SaidAlvarado/UVA---High-power-ultraviolet-flashlight/PCB/High Power Led Driver/AL8853_Led_driver/Output/AL8853_Led_driver_3d_model.png

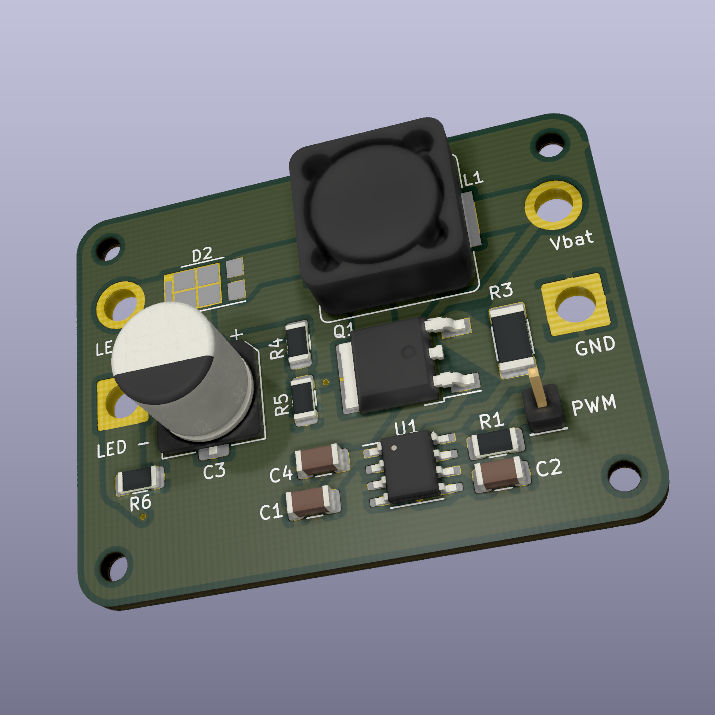
PCB/High Power Led Driver/AL8853_Led_driver/Output/AL8853_Led_driver_3d_model.png
