SaidAlvarado/UVA---High-power-ultraviolet-flashlight/Firmware/README.md

# UVA Firmware #

Main firmware for the UVA, and examples for each sensor.

## Requirements ##

1. [LM73-Q1 Temperature Sensor](examples/LM73/README.md)

2. [VL53L1X Distance Sensor](examples/VL53L1X/README.md)

3. [SSD1306 OLED](examples/SSD1306/README.md)

## Examples ##

### [LM73-Q1 Temperature Sensor](examples/LM73/README.md) ###

- [Oneshot](examples/LM73/oneshot/oneshot.ino): this is an example from the [LM73 Library](https://github.com/zkemble/LM73) that starts a new reading, waits until the temperature measurement is ready and then shows the results in the serial monitor. Once the measurement is ready, it starts a new one and the cycle begins again.

- [Continuous Reading](examples/LM73/continuous_reading/continuous_reading.ino): this example takes a continuous temperature readings and displays the results each 1000 mseg in the terminal monitor (9600 Baud).

### [VL53L1X Distance Sensor](examples/VL53L1X/README.md) ###

- [ReadDistance](examples/VL53L1X/Example1_ReadDistance/Example1_ReadDistance.ino): this is an example from the [VL53L1X Library](https://github.com/sparkfun/SparkFun_VL53L1X_Arduino_Library) that starts a new reading, waits until the distance measurement is ready and then shows the results in the serial monitor. Once the measurement is ready, it starts a new one and the cycle begins again.

### [SSD1306 OLED](examples/SSD1306/README.md) ###

- [SSD1306 128x64 I2C Demo](examples/SSD1306/ssd1306_128x64_i2c/ssd1306_128x64_i2c.ino): this is an example from the [Adafruit SSD1306 Library](https://github.com/adafruit/Adafruit_SSD1306) that plays a demo, it tests all the different functions in the library.

## Main ##

- [uva-main](uva-main/uva-main.ino): This is the completed firmware of the Flashlight. It reads all the sensors, turns on the LEDs at 100mW/cm^2 and reports relevant information to the OLED screen.
