SaidAlvarado/UVA---High-power-ultraviolet-flashlight/Firmware/examples/SSD1306/README.md

# OLED SSD1306 #

* [Library](https://github.com/adafruit/Adafruit_SSD1306)

## Installation ##

If you are using version 1.6.2 or later of the Arduino software (IDE), you can use the Library Manager to install this library:

1. In the Arduino IDE, open the "Sketch" menu, select "Include Library", then "Manage Libraries...".
2. Search for "SSD1306".
3. Click the "Adafruit SSD1306" entry in the list.
4. Click "Install".

If this does not work, you can manually install the library:

1. Download the [latest release archive from GitHub](https://github.com/adafruit/Adafruit_SSD1306/archive/master.zip) and decompress it.
2. Rename the folder "Adafruit_SSD1306-master" to "Adafruit_SSD1306".
3. Move the "Adafruit_SSD1306" folder into the "libraries" directory inside your Arduino sketchbook directory. You can view your sketchbook location by opening the "File" menu and selecting "Preferences" in the Arduino IDE. If there is not already a "libraries" folder in that location, you should make the folder yourself.
After installing the library, restart the Arduino IDE.
4. After installing the library, restart the Arduino IDE.

## Examples ##

* [SSD1306 128x64 I2C Demo](./ssd1306_128x64_i2c/ssd1306_128x64_i2c.ino): this is an example from the [Adafruit SSD1306 Library](https://github.com/adafruit/Adafruit_SSD1306) that plays a demo, it tests all the different functions in the library.
