SaidAlvarado/UVA---High-power-ultraviolet-flashlight/Firmware/examples/VL53L1X/README.md

# VL53L1X Distance Sensor #

* [Library](https://github.com/sparkfun/SparkFun_VL53L1X_Arduino_Library)

## Installation ##

If you are using version 1.6.2 or later of the Arduino software (IDE), you can use the Library Manager to install this library:

1. In the Arduino IDE, open the "Sketch" menu, select "Include Library", then "Manage Libraries...".
2. Search for "VL53L1X".
3. Click the "SparkFun VL53L1X 4m Laser Distance Sensor" entry in the list.
4. Click "Install".

If this does not work, you can manually install the library:

1. Download the [latest release archive from GitHub](https://github.com/sparkfun/SparkFun_VL53L1X_Arduino_Library/archive/master.zip) and decompress it.
2. Rename the folder "SparkFun_VL53L1X_Arduino_Library-master" to "SparkFun_VL53L1X_Arduino_Library".
3. Move the "SparkFun_VL53L1X_Arduino_Library" folder into the "libraries" directory inside your Arduino sketchbook directory. You can view your sketchbook location by opening the "File" menu and selecting "Preferences" in the Arduino IDE. If there is not already a "libraries" folder in that location, you should make the folder yourself.
After installing the library, restart the Arduino IDE.
4. After installing the library, restart the Arduino IDE.

## Examples ##

* [ReadDistance](./Example1_ReadDistance/Example1_ReadDistance.ino):  this is an example from the [VL53L1X Library](https://github.com/sparkfun/SparkFun_VL53L1X_Arduino_Library) that starts a new reading, waits until the distance measurement is ready and then shows the results in the serial monitor. Once the measurement is ready, it starts a new one and the cycle begins again.
