SaidAlvarado/UVA---High-power-ultraviolet-flashlight/PCB/High Power Led Driver/AL8853_Led_driver/Output/g1480.png

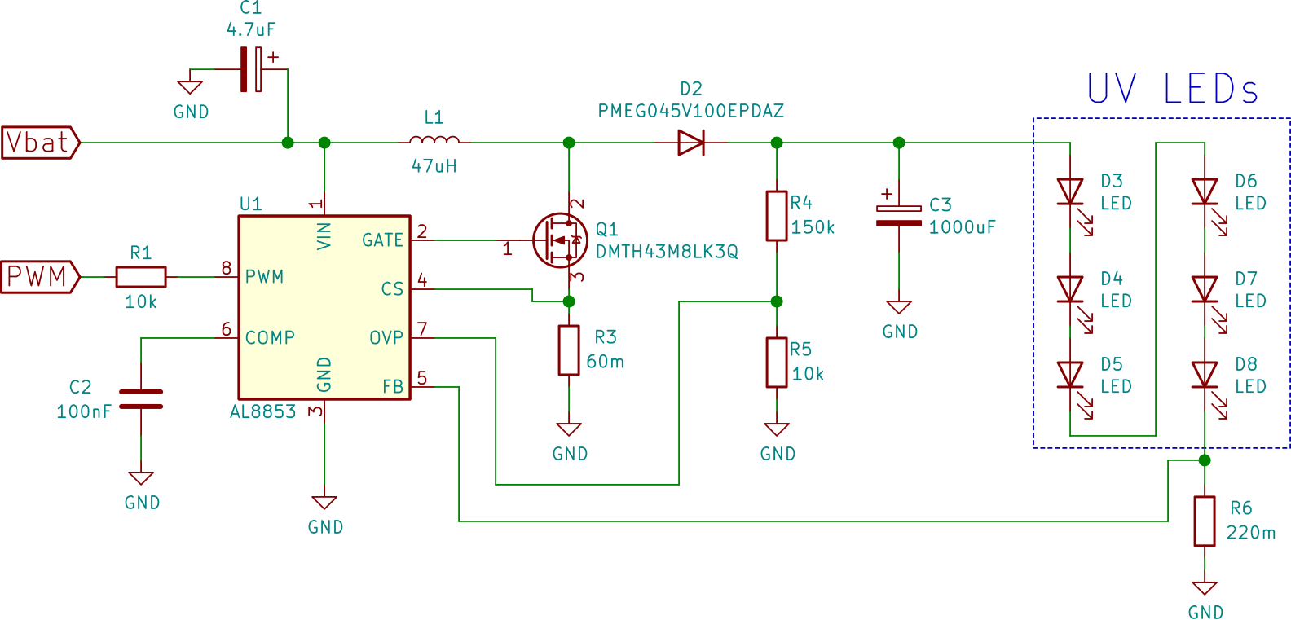
PCB/High Power Led Driver/AL8853_Led_driver/Output/g1480.png
