SaidAlvarado/UVA---High-power-ultraviolet-flashlight/PCB/High Power Led Driver/AL8853_Led_driver/AL8853_Led_driver.step

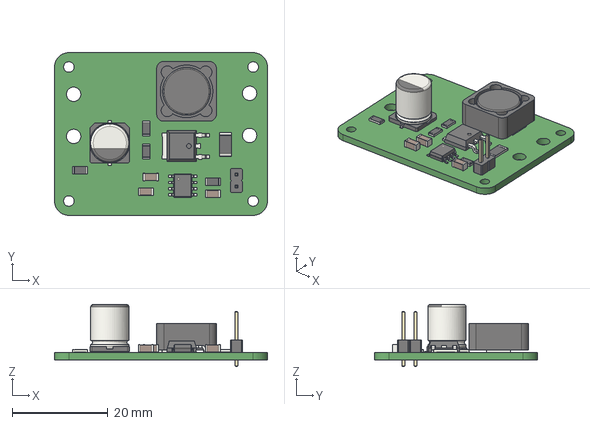
[picture p3: CAD file, 2020-10-05]
PCB/High Power Led Driver/AL8853_Led_driver/AL8853_Led_driver.step
44.5 x 34.0 x 13.0 mm
