SaidAlvarado/UVA---High-power-ultraviolet-flashlight/PCB/UV LED BULB/inulox_led_bulb/inulox_led_bulb.step

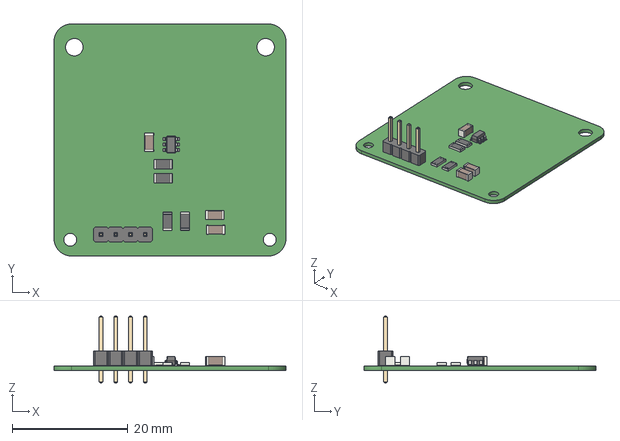
[picture p4: CAD file, 2020-10-05]
PCB/UV LED BULB/inulox_led_bulb/inulox_led_bulb.step
40.0 x 40.0 x 11.5 mm
