SaidAlvarado/UVA---High-power-ultraviolet-flashlight/PCB/Arduino CPU Board/Arduino_CPU_Board/ouput/Arduino_CPU_Board.pdf

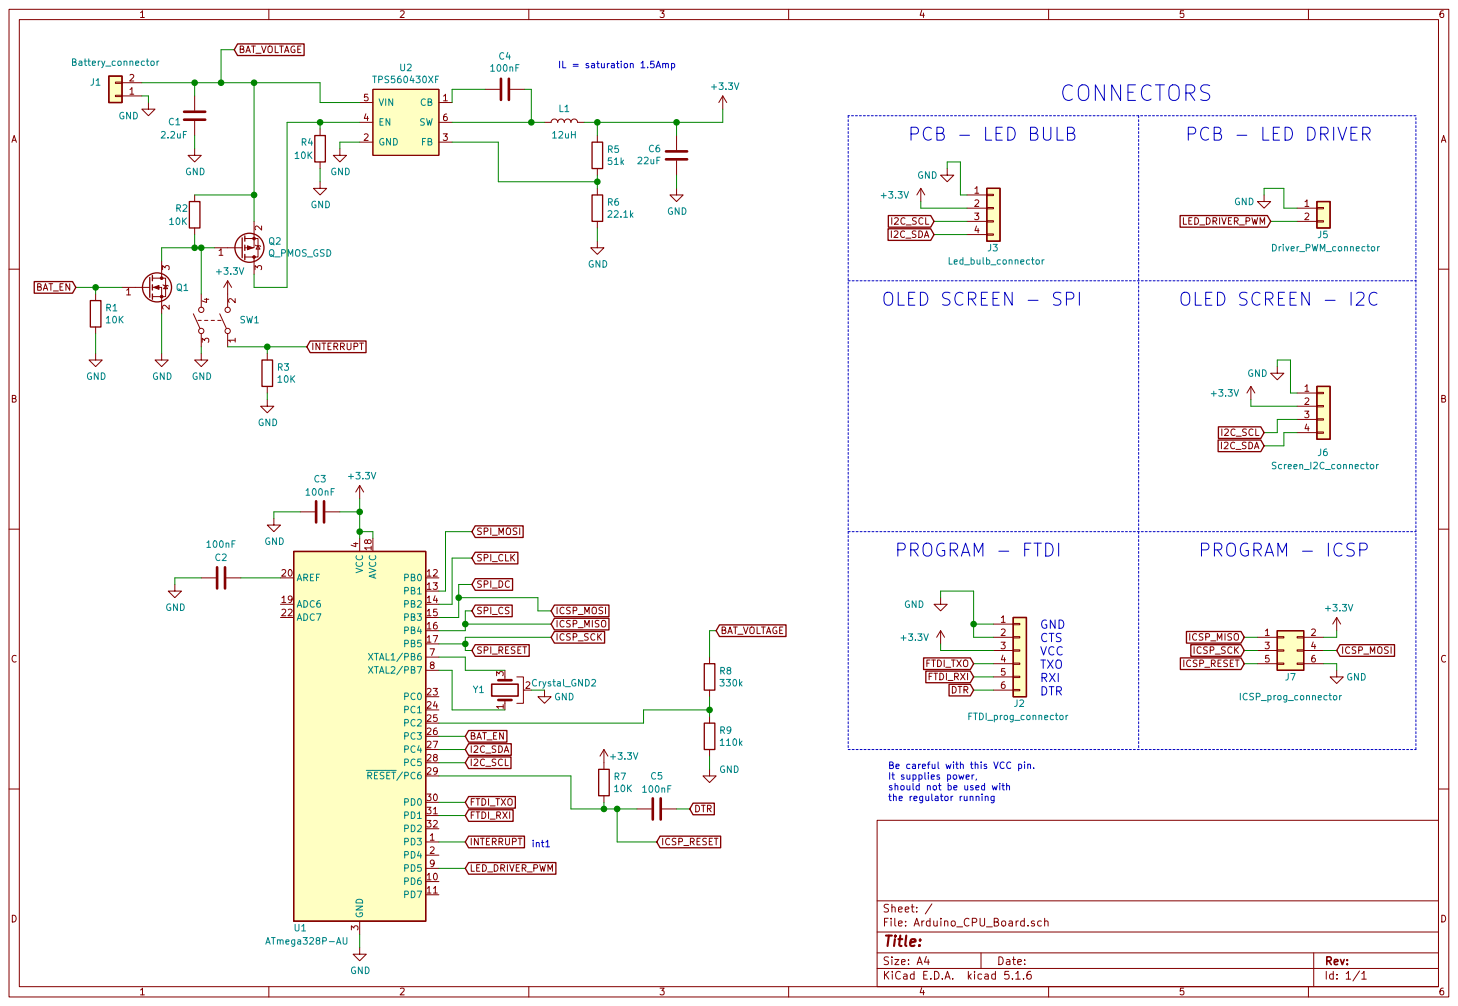
[picture p5: page 1]

It supplies power, should not be used with
