SaidAlvarado/UVA---High-power-ultraviolet-flashlight/PCB/High Power Led Driver/AL8853_Led_driver/Output/AL8853_Led_driver.pdf

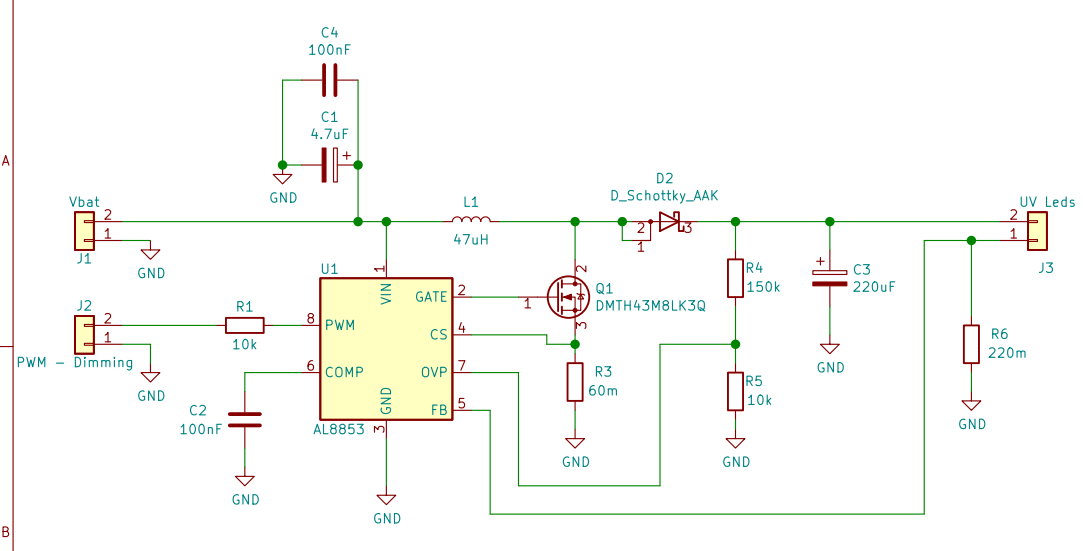
[picture p6: page 1]

3 CS 4 FB 5 COMP 6 OVP 7 PWM 8 U1 AL8853 GND

File: AL8853_Led_driver.sch Sheet: /
Id: 1/1 Title: AL8853 Constant Current - 24w - UV LED Driver
