SaidAlvarado/UVA---High-power-ultraviolet-flashlight/PCB/UV LED BULB/inulox_led_bulb/Output/inulox_led_bulb.pdf

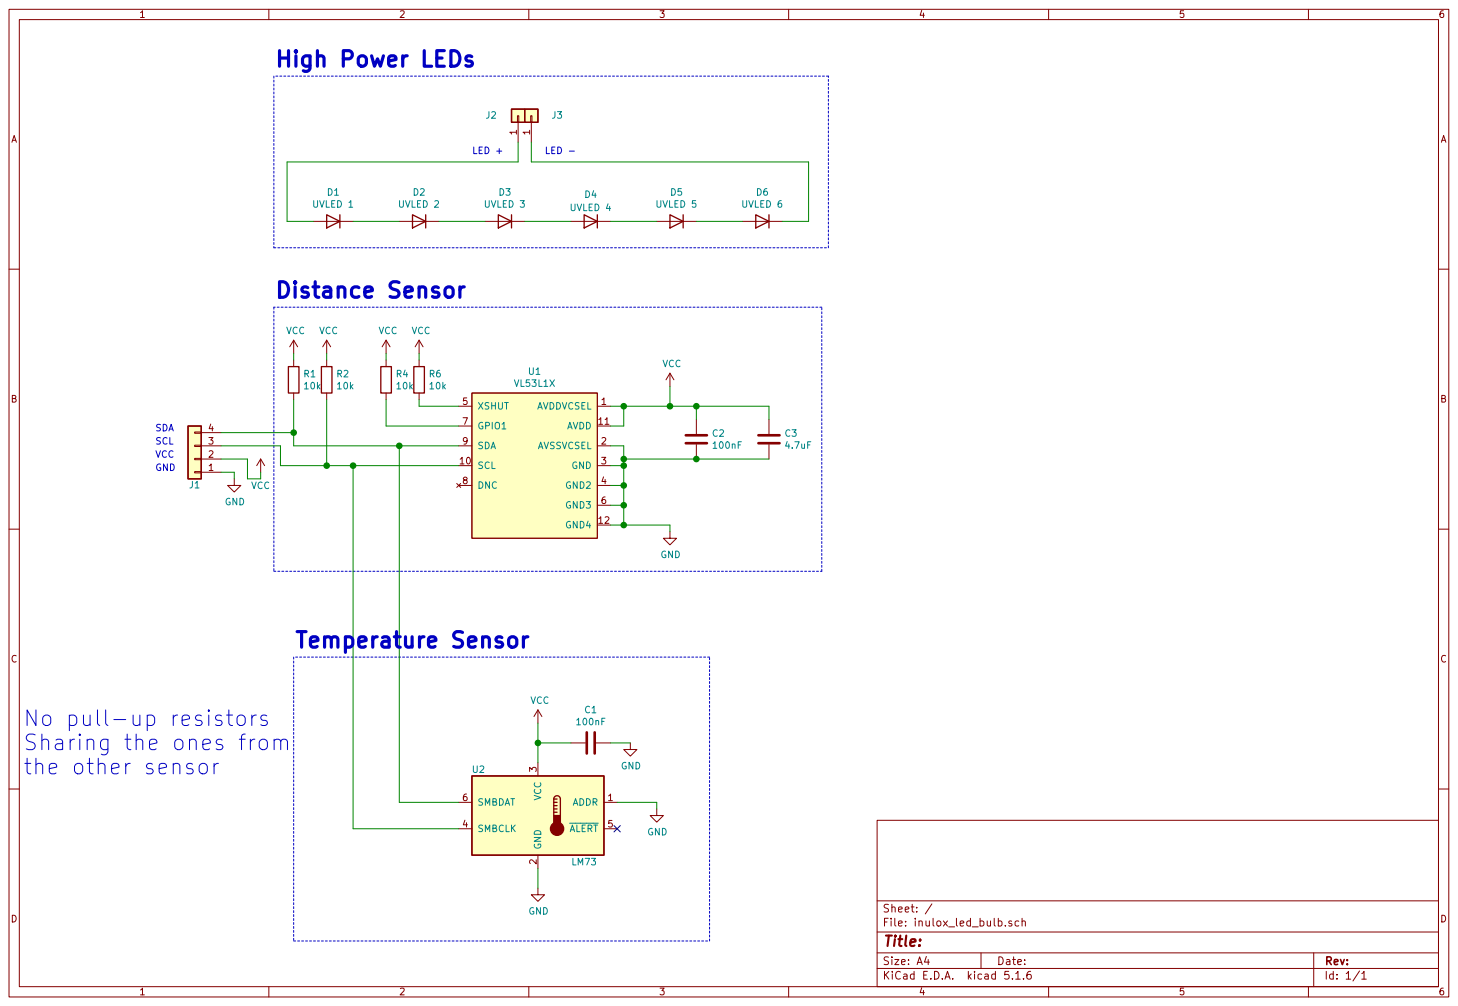
[picture p7: page 1]

Sharing the ones from
the other sensor
