SaidAlvarado/UVA---High-power-ultraviolet-flashlight/PCB/Arduino CPU Board/Arduino_CPU_Board/Arduino_CPU_Board.pdf

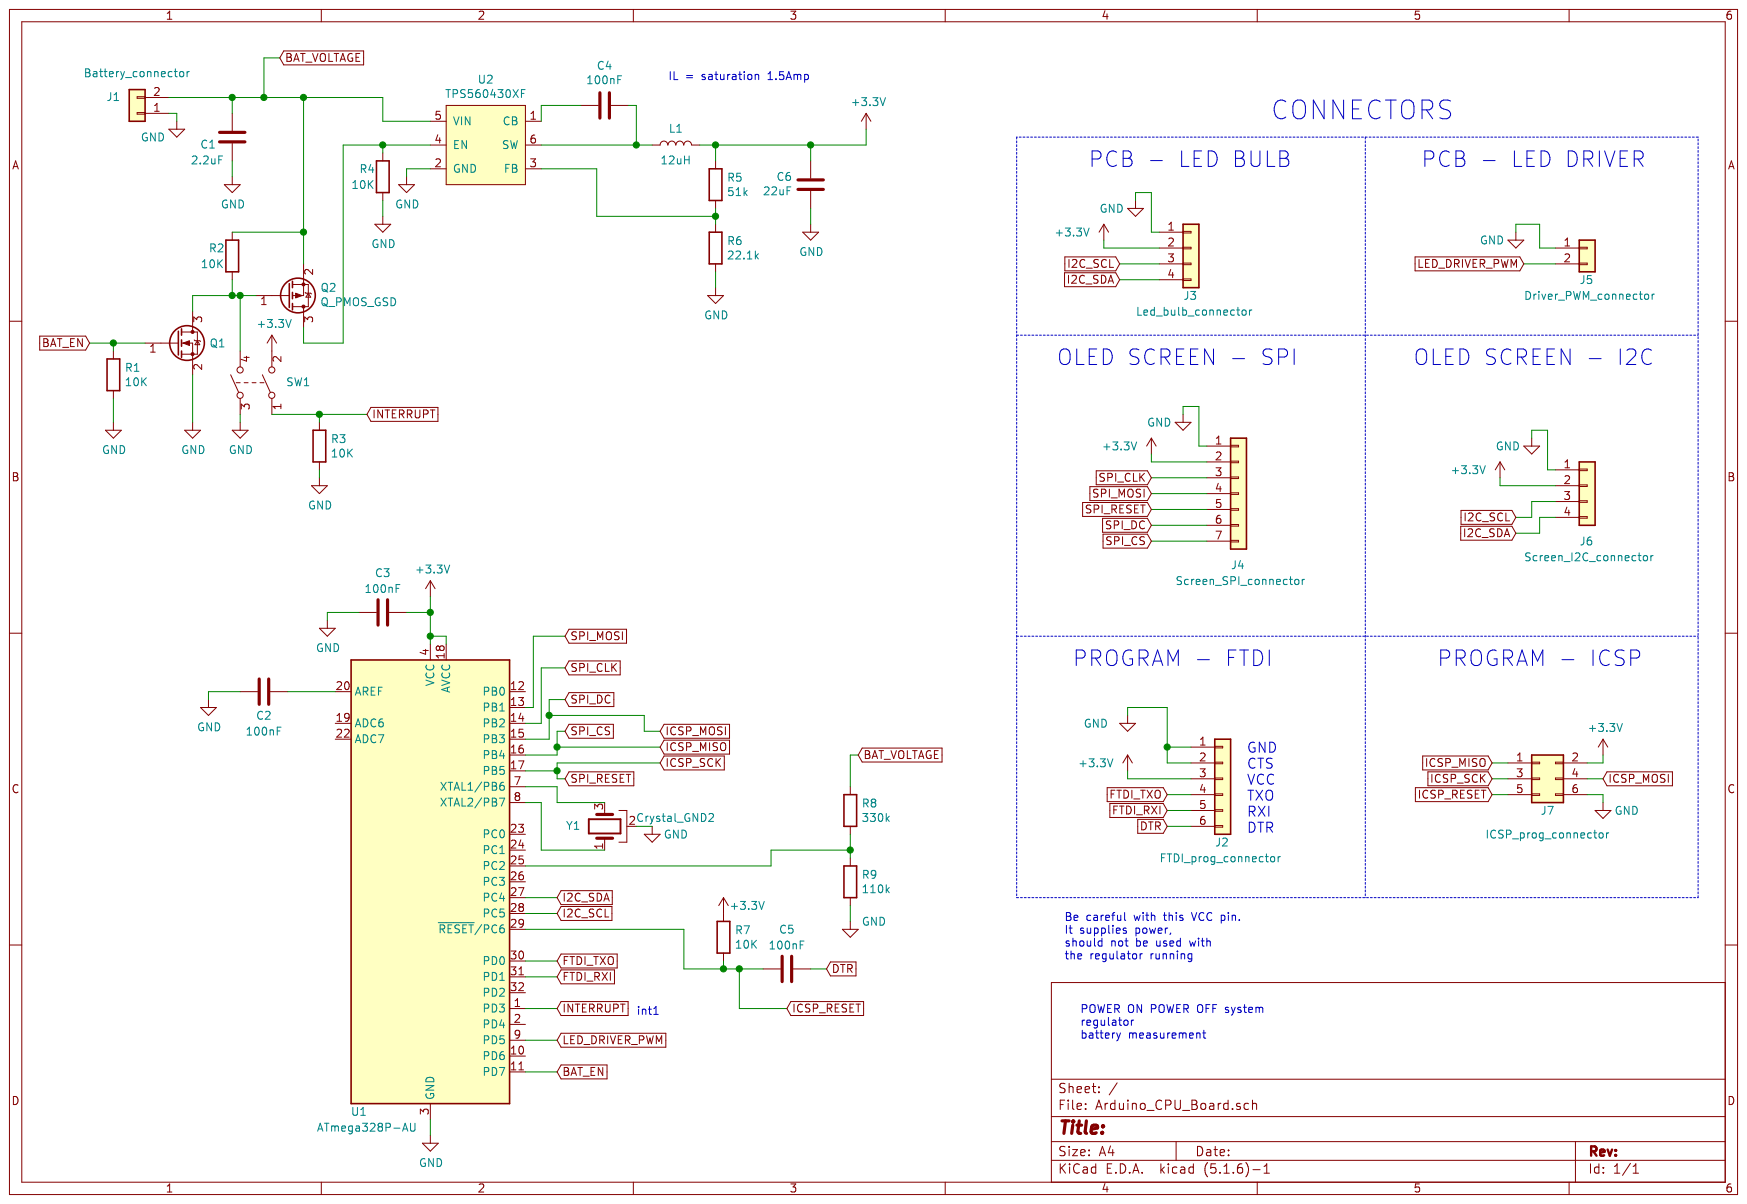
[picture p8: page 1]
