SaidAlvarado/UVA---High-power-ultraviolet-flashlight/(commit log)

2020-09-30 Added display of distance and temperature measurements in the screen
2020-10-02 Added continuous reading example to the lm73 sensor
2020-10-04 Fix: Changed LM73 address config to match schematic
    The Address pin at my circuit is set to Low. The default in the examples is for the address pin to be floating. This changes the I2C address.
    [continuous_reading.ino, oneshot.ino, uva-main.ino]
2020-10-04 Feature: Added safety shutdown off the lamp
    Made sure the LEDs are completely off at the start of every program
2020-10-04 Fix: Fixed coordinate system for portrait orientation
    And added the animation of the first couple of distance sensor things
2020-10-04 Fixed coordinates for distance and battery monitor
2020-10-04 Fix: Made the battery a bit bigger.
2020-10-04 Feat: El sensor de distance finally works
    it's like 2am, I'm tired
2020-10-05 Feat: Add PCB designs to the repo
    [AL8853_Led_driver-B_Cu.gbr, AL8853_Led_driver-B_Mask.gbr, AL8853_Led_driver-B_Paste.gbr, AL8853_Led_driver-B_SilkS.gbr, AL8853_Led_driver-Edge_Cuts.gbr, AL8853_Led_driver-F_Cu.gbr, AL8853_Led_driver-F_Mask.gbr, AL8853_Led_driver-F_Paste.gbr]
